Normansrule/twinkling-butterfly/docs/connections.md

# Pin-by-pin connections

Every pin of every active device, the net it sits on, and what else is on
that net. Generated by `hardware/make_connections.py` from the schematic
files, so it cannot drift from the design. Passive two-pin parts are listed
in the net summary at the bottom rather than getting a table each.

Net names follow the design's conventions exactly: `CHIP_ENABLE`, `BOOT`,
`LED_DATA`, `UART_RX`/`UART_TX` (named from the MCU's point of view),
`VBUS`, `VBAT`, `VBAT_SW`, `FT_3V3`, `+3.3V`, `GND`.

---

## ESP32-C3FH4 — Microcontroller

Bare QFN-32 MCU. 4 MB internal flash, so the six SPI flash pins are no-connects.

| Pin | Name | Net | Goes to |
|---|---|---|---|
| 1 | LNA_IN | — | **no connect** |
| 2 | VDD3P3 | `+3.3V` | C12.2, C19.1, C5.2, C6.2, C7.2, C8.2, C9.1, R1.1, R2.1, R3.1, R4.1,… |
| 3 | VDD3P3__1 | `+3.3V` | C12.2, C19.1, C5.2, C6.2, C7.2, C8.2, C9.1, R1.1, R2.1, R3.1, R4.1,… |
| 4 | GPIO0/XTAL_32K_P | — | **no connect** |
| 5 | GPIO1/XTAL_32K_N | — | **no connect** |
| 6 | GPIO2 | *(local)* | R2.2 |
| 7 | CHIP_EN | `CHIP_ENABLE` | C10.2, Q1.3, R1.2 |
| 8 | GPIO3 | — | **no connect** |
| 9 | GPIO4/MTMS | `LED_DATA` | R15.1 |
| 10 | GPIO5/MTDI | — | **no connect** |
| 11 | VDD3P3_RTC | `+3.3V` | C12.2, C19.1, C5.2, C6.2, C7.2, C8.2, C9.1, R1.1, R2.1, R3.1, R4.1,… |
| 12 | GPIO6/MTCK | — | **no connect** |
| 13 | GPIO7/MTDO | — | **no connect** |
| 14 | GPIO8 | *(local)* | R3.2 |
| 15 | GPIO9 | `BOOT` | Q2.3, R4.2 |
| 16 | GPIO10 | — | **no connect** |
| 17 | VDD3P3_CPU | `+3.3V` | C12.2, C19.1, C5.2, C6.2, C7.2, C8.2, C9.1, R1.1, R2.1, R3.1, R4.1,… |
| 18 | VDD_SPI | *(local)* | C11.2 |
| 19 | GPIO12/SPIHD | — | **no connect** |
| 20 | GPIO13/SPIWP | — | **no connect** |
| 21 | GPIO14/SPICS0 | — | **no connect** |
| 22 | GPIO15/SPICLK | — | **no connect** |
| 23 | GPIO16/SPID | — | **no connect** |
| 24 | GPIO17/SPIQ | — | **no connect** |
| 25 | GPIO18/USB_D- | `USB_DATA-` | TP2.1 |
| 26 | GPIO19/USB_D+ | `USB_DATA+` | TP1.1 |
| 27 | GPIO20/U0RXD | `UART_RX` | R9.2 |
| 28 | GPIO21/U0TXD | `UART_TX` | R10.2 |
| 29 | XTAL_N | `Crystal-` | 40.0MHz-Crystral.3, C4.2 |
| 30 | XTAL_P | `Crystal+` | 40.0MHz-Crystral.1, C3.2 |
| 31 | VDDA | `+3.3V` | C12.2, C19.1, C5.2, C6.2, C7.2, C8.2, C9.1, R1.1, R2.1, R3.1, R4.1,… |
| 32 | VDDA__1 | `+3.3V` | C12.2, C19.1, C5.2, C6.2, C7.2, C8.2, C9.1, R1.1, R2.1, R3.1, R4.1,… |
| 33 | GND | `GND` | 40.0MHz-Crystral.2, 40.0MHz-Crystral.4, BT1a.2, BT1b.2, C10.1, C11.… |

## U5 — USB / UART

USB to UART bridge. Runs from 5 V VBUS and regulates its own 3.3 V I/O.

| Pin | Name | Net | Goes to |
|---|---|---|---|
| 1 | ~{DTR} | `DTR` | Q2.2, R7.1 |
| 2 | ~{RTS} | `RTS` | Q1.2, R8.1 |
| 3 | VCCIO | `FT_3V3` | C15.1 |
| 4 | RXD | `FT_RXD` | R10.1 |
| 5 | ~{RI} | — | **no connect** |
| 6 | GND | `GND` | 40.0MHz-Crystral.2, 40.0MHz-Crystral.4, BT1a.2, BT1b.2, C10.1, C11.… |
| 7 | ~{DSR} | — | **no connect** |
| 8 | ~{DCD} | — | **no connect** |
| 9 | ~{CTS} | `GND` | 40.0MHz-Crystral.2, 40.0MHz-Crystral.4, BT1a.2, BT1b.2, C10.1, C11.… |
| 10 | CBUS2 | — | **no connect** |
| 11 | USBDP | `USB_DP` | R11.2 |
| 12 | USBDM | `USB_DM` | R12.2 |
| 13 | 3V3OUT | `FT_3V3` | C15.1 |
| 14 | ~{RESET} | `FT_3V3` | C15.1 |
| 15 | VCC | `VBUS` | C13.1, C14.1, C16.1, J1.A4/B9, J1.B4/A9, R13.1, U2.4, U4.5 |
| 16 | GND__1 | `GND` | 40.0MHz-Crystral.2, 40.0MHz-Crystral.4, BT1a.2, BT1b.2, C10.1, C11.… |
| 17 | CBUS1 | — | **no connect** |
| 18 | CBUS0 | — | **no connect** |
| 19 | CBUS3 | — | **no connect** |
| 20 | TXD | `FT_TXD` | R9.1 |

## U4 — USB / UART

USB ESD protection. Pins 1/6 are one node, 3/4 are the other.

| Pin | Name | Net | Goes to |
|---|---|---|---|
| 1 | ~ | `USB_DP_CONN` | J1.A6, J1.B6 |
| 2 | ~ | `GND` | 40.0MHz-Crystral.2, 40.0MHz-Crystral.4, BT1a.2, BT1b.2, C10.1, C11.… |
| 3 | ~ | `USB_DM_CONN` | J1.A7, J1.B7 |
| 4 | ~ | `USB_DM_P` | R12.1 |
| 5 | ~ | `VBUS` | C13.1, C14.1, C16.1, J1.A4/B9, J1.B4/A9, R13.1, U2.4, U5.15 |
| 6 | ~ | `USB_DP_P` | R11.1 |

## J1 — USB / UART

USB-C receptacle. Both halves of the data pair are tied so the cable can go in either way up.

| Pin | Name | Net | Goes to |
|---|---|---|---|
| A1/B12 | GND | `GND` | 40.0MHz-Crystral.2, 40.0MHz-Crystral.4, BT1a.2, BT1b.2, C10.1, C11.… |
| A4/B9 | VBUS | `VBUS` | C13.1, C14.1, C16.1, R13.1, U2.4, U4.5, U5.15 |
| A5 | CC1 | `CC1` | R5.1 |
| A6 | DP1 | `USB_DP_CONN` | U4.1 |
| A7 | DN1 | `USB_DM_CONN` | U4.3 |
| A8 | SBU1 | — | **no connect** |
| B1/A12 | GND__1 | `GND` | 40.0MHz-Crystral.2, 40.0MHz-Crystral.4, BT1a.2, BT1b.2, C10.1, C11.… |
| B4/A9 | VBUS__1 | `VBUS` | C13.1, C14.1, C16.1, R13.1, U2.4, U4.5, U5.15 |
| B5 | CC2 | `CC2` | R6.1 |
| B6 | DP2 | `USB_DP_CONN` | U4.1 |
| B7 | DN2 | `USB_DM_CONN` | U4.3 |
| B8 | SBU2 | — | **no connect** |
| S1 | GND__2 | `GND` | 40.0MHz-Crystral.2, 40.0MHz-Crystral.4, BT1a.2, BT1b.2, C10.1, C11.… |
| S2 | GND__3 | `GND` | 40.0MHz-Crystral.2, 40.0MHz-Crystral.4, BT1a.2, BT1b.2, C10.1, C11.… |
| S3 | GND__4 | `GND` | 40.0MHz-Crystral.2, 40.0MHz-Crystral.4, BT1a.2, BT1b.2, C10.1, C11.… |
| S4 | GND__5 | `GND` | 40.0MHz-Crystral.2, 40.0MHz-Crystral.4, BT1a.2, BT1b.2, C10.1, C11.… |

## Q1 — USB / UART

Pulls CHIP_ENABLE for esptool's auto-reset.

| Pin | Name | Net | Goes to |
|---|---|---|---|
| 1 | ~ | `Q1_BASE` | R7.2 |
| 2 | ~ | `RTS` | R8.1, U5.2 |
| 3 | ~ | `CHIP_ENABLE` | C10.2, ESP32-C3FH4.7, R1.2 |

## Q2 — USB / UART

Pulls BOOT for esptool's auto-reset.

| Pin | Name | Net | Goes to |
|---|---|---|---|
| 1 | ~ | `Q2_BASE` | R8.2 |
| 2 | ~ | `DTR` | R7.1, U5.1 |
| 3 | ~ | `BOOT` | ESP32-C3FH4.15, R4.2 |

## U2 — Power

Li-ion charge controller. I_REG(mA) = 1000 / R_PROG(kOhm); 24 kOhm gives ~42 mA.

| Pin | Name | Net | Goes to |
|---|---|---|---|
| 1 | STAT | `STAT` | D7.2 |
| 2 | VSS | `GND` | 40.0MHz-Crystral.2, 40.0MHz-Crystral.4, BT1a.2, BT1b.2, C10.1, C11.… |
| 3 | VBAT | `VBAT` | BT1a.1, BT1b.1, C17.1, SW1.1 |
| 4 | VDD | `VBUS` | C13.1, C14.1, C16.1, J1.A4/B9, J1.B4/A9, R13.1, U4.5, U5.15 |
| 5 | PROG | `PROG` | R14.1 |

## U3 — Power

3.3 V LDO for the MCU only. EN tied to VIN so SW1 kills it.

| Pin | Name | Net | Goes to |
|---|---|---|---|
| 1 | VIN | `VBAT_SW` | C18.1, C20.1, C21.1, C22.1, C23.1, C24.1, C25.1, C26.1, D1.1, D2.1,… |
| 2 | GND | `GND` | 40.0MHz-Crystral.2, 40.0MHz-Crystral.4, BT1a.2, BT1b.2, C10.1, C11.… |
| 3 | EN | `VBAT_SW` | C18.1, C20.1, C21.1, C22.1, C23.1, C24.1, C25.1, C26.1, D1.1, D2.1,… |
| 4 | NC | — | **no connect** |
| 5 | VOUT | `+3.3V` | C12.2, C19.1, C5.2, C6.2, C7.2, C8.2, C9.1, ESP32-C3FH4.11, ESP32-C… |

## SW1 — Power

SPDT slide switch, surface mount. Pin 2 is the common terminal.

| Pin | Name | Net | Goes to |
|---|---|---|---|
| 1 | A | `VBAT` | BT1a.1, BT1b.1, C17.1, U2.3 |
| 2 | COM | `VBAT_SW` | C18.1, C20.1, C21.1, C22.1, C23.1, C24.1, C25.1, C26.1, D1.1, D2.1,… |
| 3 | B | — | **no connect** |

## D1 — LED chain

| Pin | Name | Net | Goes to |
|---|---|---|---|
| 1 | VDD | `VBAT_SW` | C18.1, C20.1, C21.1, C22.1, C23.1, C24.1, C25.1, C26.1, D2.1, D3.1,… |
| 2 | DOUT | `PIX_D1` | D2.4 |
| 3 | VSS | `GND` | 40.0MHz-Crystral.2, 40.0MHz-Crystral.4, BT1a.2, BT1b.2, C10.1, C11.… |
| 4 | DIN | `PIX_D0` | R15.2 |

## D2 — LED chain

| Pin | Name | Net | Goes to |
|---|---|---|---|
| 1 | VDD | `VBAT_SW` | C18.1, C20.1, C21.1, C22.1, C23.1, C24.1, C25.1, C26.1, D1.1, D3.1,… |
| 2 | DOUT | `PIX_D2` | D3.4 |
| 3 | VSS | `GND` | 40.0MHz-Crystral.2, 40.0MHz-Crystral.4, BT1a.2, BT1b.2, C10.1, C11.… |
| 4 | DIN | `PIX_D1` | D1.2 |

## D3 — LED chain

| Pin | Name | Net | Goes to |
|---|---|---|---|
| 1 | VDD | `VBAT_SW` | C18.1, C20.1, C21.1, C22.1, C23.1, C24.1, C25.1, C26.1, D1.1, D2.1,… |
| 2 | DOUT | `PIX_D3` | D4.4 |
| 3 | VSS | `GND` | 40.0MHz-Crystral.2, 40.0MHz-Crystral.4, BT1a.2, BT1b.2, C10.1, C11.… |
| 4 | DIN | `PIX_D2` | D2.2 |

## D4 — LED chain

| Pin | Name | Net | Goes to |
|---|---|---|---|
| 1 | VDD | `VBAT_SW` | C18.1, C20.1, C21.1, C22.1, C23.1, C24.1, C25.1, C26.1, D1.1, D2.1,… |
| 2 | DOUT | `PIX_D4` | D5.4 |
| 3 | VSS | `GND` | 40.0MHz-Crystral.2, 40.0MHz-Crystral.4, BT1a.2, BT1b.2, C10.1, C11.… |
| 4 | DIN | `PIX_D3` | D3.2 |

## D5 — LED chain

| Pin | Name | Net | Goes to |
|---|---|---|---|
| 1 | VDD | `VBAT_SW` | C18.1, C20.1, C21.1, C22.1, C23.1, C24.1, C25.1, C26.1, D1.1, D2.1,… |
| 2 | DOUT | `PIX_D5` | D6.4 |
| 3 | VSS | `GND` | 40.0MHz-Crystral.2, 40.0MHz-Crystral.4, BT1a.2, BT1b.2, C10.1, C11.… |
| 4 | DIN | `PIX_D4` | D4.2 |

## D6 — LED chain

| Pin | Name | Net | Goes to |
|---|---|---|---|
| 1 | VDD | `VBAT_SW` | C18.1, C20.1, C21.1, C22.1, C23.1, C24.1, C25.1, C26.1, D1.1, D2.1,… |
| 2 | DOUT | — | **no connect** |
| 3 | VSS | `GND` | 40.0MHz-Crystral.2, 40.0MHz-Crystral.4, BT1a.2, BT1b.2, C10.1, C11.… |
| 4 | DIN | `PIX_D5` | D5.2 |

## D7 — Power

| Pin | Name | Net | Goes to |
|---|---|---|---|
| 1 | A | `CHG_A` | R13.2 |
| 2 | K | `STAT` | U2.1 |

## 40.0MHz-Crystral — Microcontroller

| Pin | Name | Net | Goes to |
|---|---|---|---|
| 1 | ~ | `Crystal+` | C3.2, ESP32-C3FH4.30 |
| 2 | GND | `GND` | BT1a.2, BT1b.2, C10.1, C11.1, C12.1, C13.2, C14.2, C15.2, C16.2, C1… |
| 3 | ~ | `Crystal-` | C4.2, ESP32-C3FH4.29 |
| 4 | GND__1 | `GND` | BT1a.2, BT1b.2, C10.1, C11.1, C12.1, C13.2, C14.2, C15.2, C16.2, C1… |

---

## Every net

| Net | Pins on it |
|---|---|
| `+3.3V` | C12.2, C19.1, C5.2, C6.2, C7.2, C8.2, C9.1, ESP32-C3FH4.11, ESP32-C3FH4.17, ESP32-C3FH4.2, ESP32-C3FH4.3, ESP32-C3FH4.31, ESP32-C3FH4.32, R1.1, R2.1, R3.1, R4.1, U3.5 |
| `BOOT` | ESP32-C3FH4.15, Q2.3, R4.2 |
| `CC1` | J1.A5, R5.1 |
| `CC2` | J1.B5, R6.1 |
| `CHG_A` | D7.1, R13.2 |
| `CHIP_ENABLE` | C10.2, ESP32-C3FH4.7, Q1.3, R1.2 |
| `Crystal+` | 40.0MHz-Crystral.1, C3.2, ESP32-C3FH4.30 |
| `Crystal-` | 40.0MHz-Crystral.3, C4.2, ESP32-C3FH4.29 |
| `DTR` | Q2.2, R7.1, U5.1 |
| `FT_3V3` | C15.1, U5.13, U5.14, U5.3 |
| `FT_RXD` | R10.1, U5.4 |
| `FT_TXD` | R9.1, U5.20 |
| `GND` | 40.0MHz-Crystral.2, 40.0MHz-Crystral.4, BT1a.2, BT1b.2, C10.1, C11.1, C12.1, C13.2, C14.2, C15.2, C16.2, C17.2, C18.2, C19.2, C20.2, C21.2, C22.2, C23.2, C24.2, C25.2, C26.2, C3.1, C4.1, C5.1, C6.1, C7.1, C8.1, C9.2, D1.3, D2.3, D3.3, D4.3, D5.3, D6.3, ESP32-C3FH4.33, J1.A1/B12, J1.B1/A12, J1.S1, J1.S2, J1.S3, J1.S4, R14.2, R5.2, R6.2, U2.2, U3.2, U4.2, U5.16, U5.6, U5.9 |
| `LED_DATA` | ESP32-C3FH4.9, R15.1 |
| `PIX_D0` | D1.4, R15.2 |
| `PIX_D1` | D1.2, D2.4 |
| `PIX_D2` | D2.2, D3.4 |
| `PIX_D3` | D3.2, D4.4 |
| `PIX_D4` | D4.2, D5.4 |
| `PIX_D5` | D5.2, D6.4 |
| `PROG` | R14.1, U2.5 |
| `Q1_BASE` | Q1.1, R7.2 |
| `Q2_BASE` | Q2.1, R8.2 |
| `RTS` | Q1.2, R8.1, U5.2 |
| `STAT` | D7.2, U2.1 |
| `UART_RX` | ESP32-C3FH4.27, R9.2 |
| `UART_TX` | ESP32-C3FH4.28, R10.2 |
| `USB_DATA+` | ESP32-C3FH4.26, TP1.1 |
| `USB_DATA-` | ESP32-C3FH4.25, TP2.1 |
| `USB_DM` | R12.2, U5.12 |
| `USB_DM_CONN` | J1.A7, J1.B7, U4.3 |
| `USB_DM_P` | R12.1, U4.4 |
| `USB_DP` | R11.2, U5.11 |
| `USB_DP_CONN` | J1.A6, J1.B6, U4.1 |
| `USB_DP_P` | R11.1, U4.6 |
| `VBAT` | BT1a.1, BT1b.1, C17.1, SW1.1, U2.3 |
| `VBAT_SW` | C18.1, C20.1, C21.1, C22.1, C23.1, C24.1, C25.1, C26.1, D1.1, D2.1, D3.1, D4.1, D5.1, D6.1, SW1.2, U3.1, U3.3 |
| `VBUS` | C13.1, C14.1, C16.1, J1.A4/B9, J1.B4/A9, R13.1, U2.4, U4.5, U5.15 |
| `__NC__` |  |
