Normansrule/twinkling-butterfly/docs/handoff-2026-08-31.md

# Twinkling Butterfly — Project Handoff
### Custom PCB, KiCad 10.0.5, hierarchical schematic | Handoff date: August 31, 2026

## What this project is

A butterfly-shaped ornament with 6 addressable RGB LEDs (WS2812B) that twinkle at night. Powered by two LIR2032 rechargeable coin cells in parallel (~80 mAh), charged over USB-C, reprogrammable over the same USB-C port via an onboard USB-to-UART bridge with auto-program transistors (no BOOT/RESET buttons — the only physical control is a power slide switch). Everything hand-soldered: all passives 1206 or larger, leaded or large-pad packages everywhere except the QFN-32 MCU, SSOP-20 bridge, SOT-23 parts, and the USB-C connector.

## Architecture in one paragraph

USB-C VBUS feeds an MCP73831 charger (≈42 mA via 24 kΩ PROG) into the battery pair, and feeds the FT231XS bridge's VCC directly. The battery runs through slide switch SW1 into an AP2112K-3.3 LDO for the ESP32-C3FH4 (bare chip, 4 MB internal flash, 40 MHz crystal). The FT231XS converts USB to UART on GPIO20/21 and its DTR#/RTS# drive two cross-coupled MMBT2222A transistors that pull CHIP_EN and GPIO9 for esptool's one-click flashing. GPIO4 drives the WS2812B chain (powered from the switched battery rail, not the LDO). Native USB (GPIO18/19) goes to test pads as a backup flashing path. The charger stays wired to the battery so charging works with SW1 off; the ESP32 must be ON to flash.

## Design decisions already settled (do not relitigate without cause)

1. Bare ESP32-C3FH4 over modules — user explicitly banned modules and is comfortable with QFN and complex routing.
2. FT231XS replaced CH340C because DigiKey no longer stocks CH340C as a bare chip. Bonus: FT231XS runs from 5 V VBUS with internal 3.3 V I/O regulation, which eliminated the second LDO entirely.
3. USB4110-GF-A (all-SMD) replaced USB4105 (hybrid THT) at user request for surface-mount.
4. Two LIR2032 in parallel (NOT series) — keeps single-cell charging, 3.0–4.2 V rail, ~80 mAh, ~40–60 mA continuous capability. Same brand/batch, replaced as a pair, holders labeled LIR ONLY (CR2032 here = fire risk).
5. WS2812B ×6 (trimmed from 8: idle draw ~0.8 mA each matters on coin cells). Firmware caps brightness ~10%, max 3 pixels lit at once, light sleep between frames. Runtime ≈ 3–4 h/charge.
6. All passives 1206; crystal in 5032 4-pad package for hand-solderability.
7. Amber-only single-color LEDs and the pouch-cell/XIAO variants were earlier iterations (v1/v2) and are superseded.

## Net naming conventions (exact spellings matter)

- `CHIP_ENABLE` — ESP pin 7 node (pin + R1 10k-to-3V3 + C10 1 µF + label). Q1 collector pulls it.
- `BOOT` — GPIO9 (pin 15) node (pin + R4 10k-to-3V3 + label, deliberately NO cap). Q2 collector pulls it.
- `LED_DATA` — GPIO4 (pin 9) → 470 Ω → first WS2812B DIN.
- `UART_RX` / `UART_TX` — named from the MCU's point of view. UART_TX (ESP pin 28) → FT231XS RXD; UART_RX (ESP pin 27) ← FT231XS TXD. Each has a 470 Ω series resistor on the bridge side.
- `USB_DATA+` / `USB_DATA−` — GPIO19/18 to test pads on the MCU sheet (backup native-USB flashing).
- `VBUS` (5 V from USB), `+3.3V` (battery-fed LDO output), `VBAT_SW` (switched battery rail feeding LDO and LED chain), GND. Power symbols are global; only signals use hierarchical labels/sheet pins.

## Current KiCad state

- Root: Main.kicad_sch. Child sheet "Microcontroller" exists; its 7 sheet pins are imported into the root.
- **Microcontroller sheet: COMPLETE and reviewed.** All 33 pins dispositioned: power pins with caps (10 µF + 0.1 µF at VDD3P3 pins 2/3; 0.1 µF each at VDD3P3_RTC 11, VDD3P3_CPU 17, VDDA 31/32; 1 µF alone on VDD_SPI 18 with no rail connection), EPAD 33 to GND, crystal on pins 29/30 with two 12 pF caps and grounded case pads, GPIO2/GPIO8 pull-ups (no labels), CHIP_ENABLE RC + label (cap confirmed on the pin side of R1, not the 3.3 V side), BOOT pull-up + label, 14 NC flags including all six in-package-flash SPI pins (19–24) and GPIO10.
- **USB/UART sheet: fully specified, not yet drawn.** Complete pin-by-pin spec for USB4110 + USBLC6-2SC6 + FT231XS + Q1/Q2 was delivered in the prior conversation; key FT231XS facts: VCC (15) from VBUS with 4.7 µF + 0.1 µF; 3V3OUT (13) + VCCIO (3) + RESET# (14) tied as one node with 0.1 µF; CTS# (9) to GND; 27 Ω series on USBDP (11)/USBDM (12); TXD (20)→470 Ω→UART_RX; RXD (4)←470 Ω←UART_TX; DTR# (1)/RTS# (2) to the transistor cross: Q1 base←10k←DTR, emitter←RTS, collector→CHIP_ENABLE; Q2 base←10k←RTS, emitter←DTR, collector→BOOT.
- **Power sheet: not started.** MCP73831 (STAT→LED+1k→VBUS; VSS→GND; VBAT→BAT+ with 4.7 µF; VDD→VBUS with 4.7 µF; PROG→24 kΩ), SW1 common→VBAT_SW, AP2112K (VIN=VBAT_SW, EN tied to VIN, VOUT→+3.3V, 1 µF each side), two Keystone 3034 holders in parallel.
- **LED sheet: not started.** 6× WS2812B chained (VDD→VBAT_SW, VSS→GND, DOUT→next DIN), 0.1 µF per pixel, 470 µF electrolytic across VBAT_SW at the first pixel, DIN of first ←470 Ω←LED_DATA.
- KiCad libraries in use: Device:Crystal_GND24 + Crystal:Crystal_SMD_Abracon_ABM3B-4Pin_5.0x3.2mm; Battery_Management:MCP73831-2-OT; Regulator_Linear:AP2112K-3.3; Power_Protection:USBLC6-2SC6; LED:WS2812B + LED_SMD:LED_WS2812B_PLCC4_5.0x5.0mm_P3.2mm; Transistor_BJT:MMBT2222A; Interface_USB:FT231XS + Package_SO:SSOP-20_4.4x6.5mm_P0.65mm; Connector:USB_C_Receptacle_USB2.0_16P + Connector_USB:USB_C_Receptacle_GCT_USB4110-xx-A; TestPoint:TestPoint_Pad_1.5x1.5mm. Missing items → DigiKey product page "EDA & CAD Models" or SnapEDA.

## Consolidated BOM (all DigiKey search links)

| Ref | Part | Link |
|---|---|---|
| U1 | ESP32-C3FH4 (QFN-32) | https://www.digikey.com/en/products/result?keywords=ESP32-C3FH4 |
| U2 | MCP73831T-2ACI/OT | https://www.digikey.com/en/products/result?keywords=MCP73831T-2ACI%2FOT |
| U3 | AP2112K-3.3TRG1 | https://www.digikey.com/en/products/result?keywords=AP2112K-3.3TRG1 |
| U4 | USBLC6-2SC6 | https://www.digikey.com/en/products/result?keywords=USBLC6-2SC6 |
| U5 | FT231XS-R | https://www.digikey.com/en/products/result?keywords=FT231XS-R |
| Q1, Q2 | MMBT2222A ×2 | https://www.digikey.com/en/products/result?keywords=MMBT2222A |
| J1 | USB4110-GF-A | https://www.digikey.com/en/products/result?keywords=USB4110-GF-A |
| Y1 | ABM3B-40.000MHZ-10-1-U-T | https://www.digikey.com/en/products/result?keywords=ABM3B-40.000MHZ-10-1-U-T |
| BT1a/b | LIR2032 ×2 | https://www.digikey.com/en/products/result?keywords=LIR2032 |
| — | Keystone 3034 holders ×2 | https://www.digikey.com/en/products/result?keywords=Keystone%203034 |
| SW1 | OS102011MA1QN1 | https://www.digikey.com/en/products/result?keywords=OS102011MA1QN1 |
| D1–D6 | WS2812B ×6 | https://www.digikey.com/en/products/result?keywords=WS2812B |
| D_CHG | Any 1206 LED | (charge indicator) |
| 10 kΩ 1206 ×7 | R1–R4, R7, R8, +1 spare | https://www.digikey.com/en/products/result?keywords=RC1206FR-0710KL |
| 5.1 kΩ 1206 ×2 | R5, R6 (CC) | https://www.digikey.com/en/products/result?keywords=RC1206FR-075K1L |
| 470 Ω 1206 ×3 | R9, R10 (UART), R_DATA | https://www.digikey.com/en/products/result?keywords=RC1206FR-07470RL |
| 27 Ω 1206 ×2 | R11, R12 (USB) | https://www.digikey.com/en/products/result?keywords=RC1206FR-0727RL |
| 24 kΩ 1206 ×1 | R_PROG | https://www.digikey.com/en/products/result?keywords=24k%20ohm%201206%201%25 |
| 1 kΩ 1206 ×1 | charge LED | https://www.digikey.com/en/products/result?keywords=1k%20ohm%201206%201%25 |
| 12 pF C0G 1206 ×2 | C3, C4 (crystal) | https://www.digikey.com/en/products/result?keywords=C1206C120J5GACTU |
| 0.1 µF 1206 ×~12 | MCU ×5, FT231XS ×2, WS2812 ×6 | https://www.digikey.com/en/products/result?keywords=C1206C104K5RACTU |
| 1 µF 1206 ×4 | C_EN, VDD_SPI, LDO in/out | https://www.digikey.com/en/products/result?keywords=C1206C105K3RACTU |
| 4.7 µF 1206 ×3 | charger ×2, FT231XS VCC | https://www.digikey.com/en/products/result?keywords=4.7uF%201206%20X5R%2025V |
| 10 µF 1206 ×1 | MCU rail | https://www.digikey.com/en/products/result?keywords=CL31A106KAHNNNE |
| 470 µF 10 V radial ×1 | LED rail bulk | https://www.digikey.com/en/products/result?keywords=470uF%2010V%20radial |

## Firmware status

Working sketch exists (butterfly_v2_twinkle.ino from the earlier XIAO iteration): random-target twinkle logic with gamma correction, esp_random() seeding, auto-off deep sleep after 8 h. Port for this board: replace the 5-pin LEDC code with Adafruit_NeoPixel or FastLED on GPIO4, setBrightness(~25), limit to ≤3 simultaneous lit pixels, add light sleep between frames. Arduino IDE: esp32 core, board = "ESP32C3 Dev Module", flash via the FT231XS COM port (auto-reset works; no buttons).

## Remaining work, in order

1. Draw the USB/UART sheet from the spec above; import its 4 sheet pins (CHIP_ENABLE, BOOT, UART_RX, UART_TX); wire to the MCU box in root.
2. Add the two USB_DATA test pads on the MCU sheet.
3. Draw the Power sheet; draw the LED sheet.
4. Full ERC to zero (or explained) warnings.
5. Footprint assignment pass, then PCB layout. Layout notes already flagged: crystal within 5 mm of pins 29/30 with ground pour; QFN EPAD stitched with 4–9 vias (it is the chip's ONLY ground); USB pair short and matched, away from crystal; ground pour under USB-C shield pads (they're the only mechanical anchor); 470 µF at first pixel; MCP73831 thermal relief.
6. 3D check (Alt+3), DRC, fab (user 3D-prints, so the board outline should eventually be butterfly-shaped or fit a printed body).

---

# Upgrade path: proper 5 V NeoPixel drive for maximum brightness

WS2812Bs are noticeably brighter and truer-colored at 5 V — blue and green dim badly below ~3.5 V supply, which is why colors shift as a LiPo discharges. Running them at 5 V "properly" needs two additions, because two separate specs break:

**Problem 1 — supply.** The battery gives 3.0–4.2 V, so a boost converter must create the 5 V LED rail.
- **U7 — MCP1640T-I/OT** boost converter, SOT-23-6, hand-solderable — https://www.digikey.com/en/products/result?keywords=MCP1640T-I%2FOT
- **L1 — 4.7 µH power inductor**, ~1 A sat, two-pad shielded (e.g., Bourns SRN4018 series) — https://www.digikey.com/en/products/result?keywords=SRN4018-4R7M
- **C — 10 µF 1206 in, 2× 10 µF 1206 out** (same CL31A106KAHNNNE)
- **Feedback divider:** VOUT = 1.21 V × (1 + R_top/R_bot). Use **R_top = 470 kΩ, R_bot = 150 kΩ** → 5.00 V. 1206: https://www.digikey.com/en/products/result?keywords=470k%201206%201%25 and https://www.digikey.com/en/products/result?keywords=150k%201206%201%25
- Wiring: VIN + EN ← VBAT_SW (EN tied to VIN so SW1 still kills everything); SW pin → inductor → ... per the datasheet's standard boost topology (verify pin roles against the MCP1640 datasheet when drawing; SOT-23-6 is SW, GND, FB, EN, VIN, VOUT). The 5 V output becomes the new LED rail `+5V_LED`; move the 470 µF and the per-pixel 0.1 µFs onto it.

**Problem 2 — logic level.** A WS2812B at 5 V requires data-high ≥ 0.7 × VDD = 3.5 V, and the ESP32's 3.3 V no longer qualifies; pixels glitch or ignore data. The canonical fix:
- **U8 — SN74AHCT1G125DBVR**, single-gate buffer, SOT-23-5 — https://www.digikey.com/en/products/result?keywords=SN74AHCT1G125DBVR
- The AHCT family has TTL input thresholds (VIH = 2.0 V), so it reads 3.3 V cleanly while its output swings the full 5 V.
- Wiring: pin 5 VCC → `+5V_LED` with 0.1 µF; pin 3 GND; pin 2 A ← `LED_DATA` from GPIO4; pin 1 OE̅ → GND (always enabled); pin 4 Y → 470 Ω → first pixel DIN. The 470 Ω moves to the 5 V side of the buffer.

**The honest physics caveat:** boosting doubles the current story. Six pixels at even 40% brightness ≈ 290 mA at 5 V ≈ 450+ mA drawn from the battery through the boost. Two LIR2032s cannot do that — they'll sag and brown out the board. So this upgrade only makes sense paired with the 500 mAh pouch cell (swap R_PROG to 2 kΩ for ~500 mA charging, delete the coin holders, add JST S2B-PH-K-S — https://www.digikey.com/en/products/result?keywords=S2B-PH-K-S ). On the coin pair, skip the boost entirely and keep the 3.0–4.2 V direct-drive design; capped at 10% brightness the color shift is barely visible. A good compromise: lay out the boost + buffer + JST footprints on the PCB but leave them unpopulated (DNP) on coin-cell builds — one board, both personalities.

## Handoff prompt for the next chat

"I'm building a custom KiCad 10 PCB called Twinkling Butterfly — bare ESP32-C3FH4, FT231XS USB-C programming with auto-reset transistors, MCP73831 charging, 2× LIR2032 parallel, 6× WS2812B. The Microcontroller hierarchical sheet is complete and its pins are imported to root. I'm attaching the handoff doc; next task is drawing the USB/UART sheet per its spec. Walk me through it the same pin-by-pin way."
