Normansrule/twinkling-butterfly/docs/netlist.md

# Netlist

Generated by `hardware/validate_sheets.py` from the written schematic files.

| Net | Connections |
|---|---|
| `+3.3V` | C12.2, C19.1, C5.2, C6.2, C7.2, C8.2, C9.1, ESP32-C3FH4.11 (VDD3P3_RTC), ESP32-C3FH4.17 (VDD3P3_CPU), ESP32-C3FH4.2 (VDD3P3), ESP32-C3FH4.3 (VDD3P3__1), ESP32-C3FH4.31 (VDDA), ESP32-C3FH4.32 (VDDA__1), R1.1, R2.1, R3.1, R4.1, U3.5 (VOUT) |
| `BOOT` | ESP32-C3FH4.15 (GPIO9), Q2.3, R4.2 |
| `CC1` | J1.A5 (CC1), R5.1 |
| `CC2` | J1.B5 (CC2), R6.1 |
| `CHG_A` | D7.1 (A), R13.2 |
| `CHIP_ENABLE` | C10.2, ESP32-C3FH4.7 (CHIP_EN), Q1.3, R1.2 |
| `Crystal+` | 40.0MHz-Crystral.1, C3.2, ESP32-C3FH4.30 (XTAL_P) |
| `Crystal-` | 40.0MHz-Crystral.3, C4.2, ESP32-C3FH4.29 (XTAL_N) |
| `DTR` | Q2.2, R7.1, U5.1 (~{DTR}) |
| `FT_3V3` | C15.1, U5.13 (3V3OUT), U5.14 (~{RESET}), U5.3 (VCCIO) |
| `FT_RXD` | R10.1, U5.4 (RXD) |
| `FT_TXD` | R9.1, U5.20 (TXD) |
| `GND` | 40.0MHz-Crystral.2 (GND), 40.0MHz-Crystral.4 (GND__1), BT1a.2 (-), BT1b.2 (-), C10.1, C11.1, C12.1, C13.2, C14.2, C15.2, C16.2, C17.2, C18.2, C19.2, C20.2, C21.2, C22.2, C23.2, C24.2, C25.2, C26.2 (-), C3.1, C4.1, C5.1, C6.1, C7.1, C8.1, C9.2, D1.3 (VSS), D2.3 (VSS), D3.3 (VSS), D4.3 (VSS), D5.3 (VSS), D6.3 (VSS), ESP32-C3FH4.33 (GND), J1.A1/B12 (GND), J1.B1/A12 (GND__1), J1.S1 (GND__2), J1.S2 (GND__3), J1.S3 (GND__4), J1.S4 (GND__5), R14.2, R5.2, R6.2, U2.2 (VSS), U3.2 (GND), U4.2, U5.16 (GND__1), U5.6 (GND), U5.9 (~{CTS}) |
| `LED_DATA` | ESP32-C3FH4.9 (GPIO4/MTMS), R15.1 |
| `PIX_D0` | D1.4 (DIN), R15.2 |
| `PIX_D1` | D1.2 (DOUT), D2.4 (DIN) |
| `PIX_D2` | D2.2 (DOUT), D3.4 (DIN) |
| `PIX_D3` | D3.2 (DOUT), D4.4 (DIN) |
| `PIX_D4` | D4.2 (DOUT), D5.4 (DIN) |
| `PIX_D5` | D5.2 (DOUT), D6.4 (DIN) |
| `PROG` | R14.1, U2.5 (PROG) |
| `Q1_BASE` | Q1.1, R7.2 |
| `Q2_BASE` | Q2.1, R8.2 |
| `RTS` | Q1.2, R8.1, U5.2 (~{RTS}) |
| `STAT` | D7.2 (K), U2.1 (STAT) |
| `UART_RX` | ESP32-C3FH4.27 (GPIO20/U0RXD), R9.2 |
| `UART_TX` | ESP32-C3FH4.28 (GPIO21/U0TXD), R10.2 |
| `USB_DATA+` | ESP32-C3FH4.26 (GPIO19/USB_D+), TP1.1 |
| `USB_DATA-` | ESP32-C3FH4.25 (GPIO18/USB_D-), TP2.1 |
| `USB_DM` | R12.2, U5.12 (USBDM) |
| `USB_DM_CONN` | J1.A7 (DN1), J1.B7 (DN2), U4.3 |
| `USB_DM_P` | R12.1, U4.4 |
| `USB_DP` | R11.2, U5.11 (USBDP) |
| `USB_DP_CONN` | J1.A6 (DP1), J1.B6 (DP2), U4.1 |
| `USB_DP_P` | R11.1, U4.6 |
| `VBAT` | BT1a.1 (+), BT1b.1 (+), C17.1, SW1.1 (A), U2.3 (VBAT) |
| `VBAT_SW` | C18.1, C20.1, C21.1, C22.1, C23.1, C24.1, C25.1, C26.1 (+), D1.1 (VDD), D2.1 (VDD), D3.1 (VDD), D4.1 (VDD), D5.1 (VDD), D6.1 (VDD), SW1.2 (COM), U3.1 (VIN), U3.3 (EN) |
| `VBUS` | C13.1, C14.1, C16.1, J1.A4/B9 (VBUS), J1.B4/A9 (VBUS__1), R13.1, U2.4 (VDD), U4.5, U5.15 (VCC) |
| `<unnamed@(134.62, 60.96)>` | C11.2, ESP32-C3FH4.18 (VDD_SPI) |
| `<unnamed@(144.78, 71.12)>` | ESP32-C3FH4.14 (GPIO8), R3.2 |
| `<unnamed@(72.39, 83.82)>` | ESP32-C3FH4.6 (GPIO2), R2.2 |
