Normansrule/twinkling-butterfly/mechanical/butterfly_board.stl

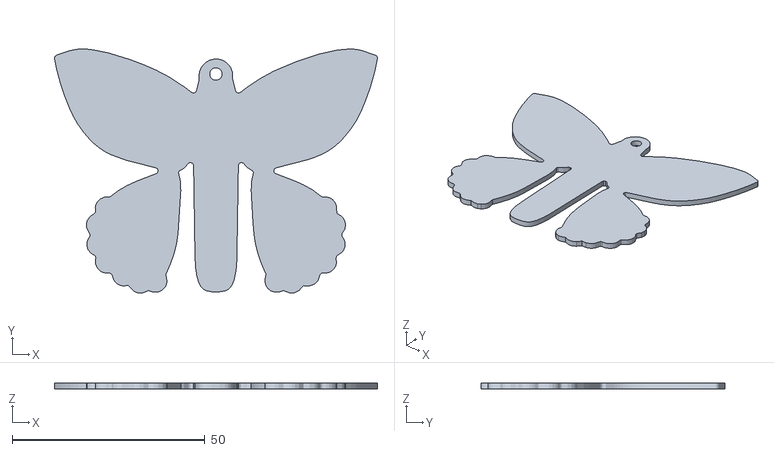
[picture p2: CAD file, 2026-10-02]
mechanical/butterfly_board.stl
83.7 x 63.3 x 1.60
