Normansrule/twinkling-butterfly/mechanical/butterfly_stand.stl

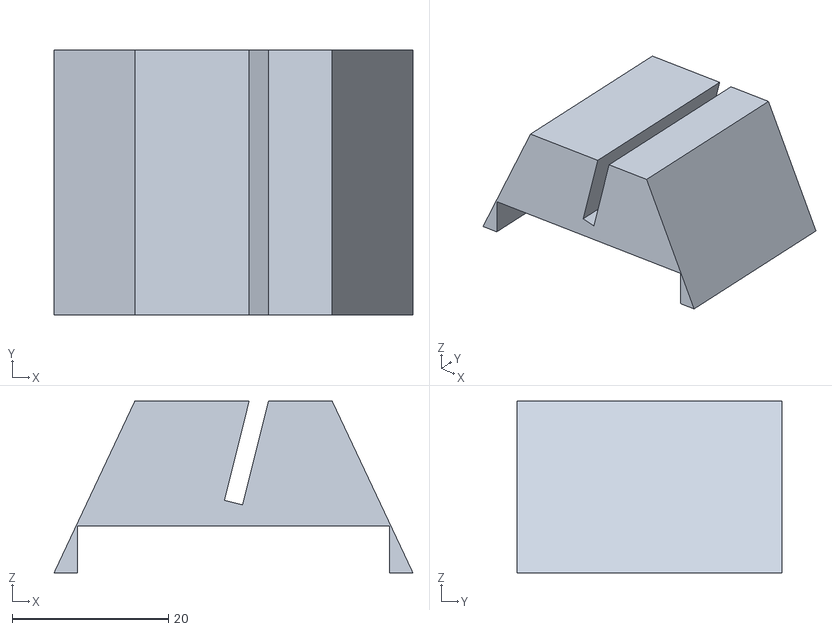
[picture p3: CAD file, 2026-10-02]
mechanical/butterfly_stand.stl
46.0 x 34.0 x 22.0
