Normansrule/twinkling-butterfly/mechanical/butterfly_outline.dxf

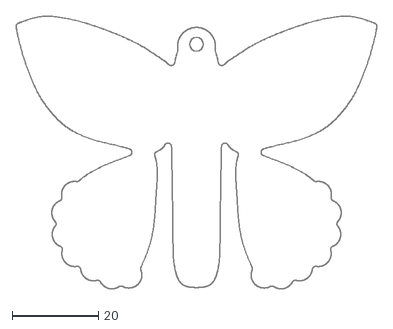
[picture p4: CAD file, 2026-10-02]
mechanical/butterfly_outline.dxf
83.8 x 63.3
