Normansrule/twinkling-butterfly/hardware/LED Butterfly/LED.kicad_sch

## KiCad design hardware/LED Butterfly/LED.kicad_sch (2026-10-02)

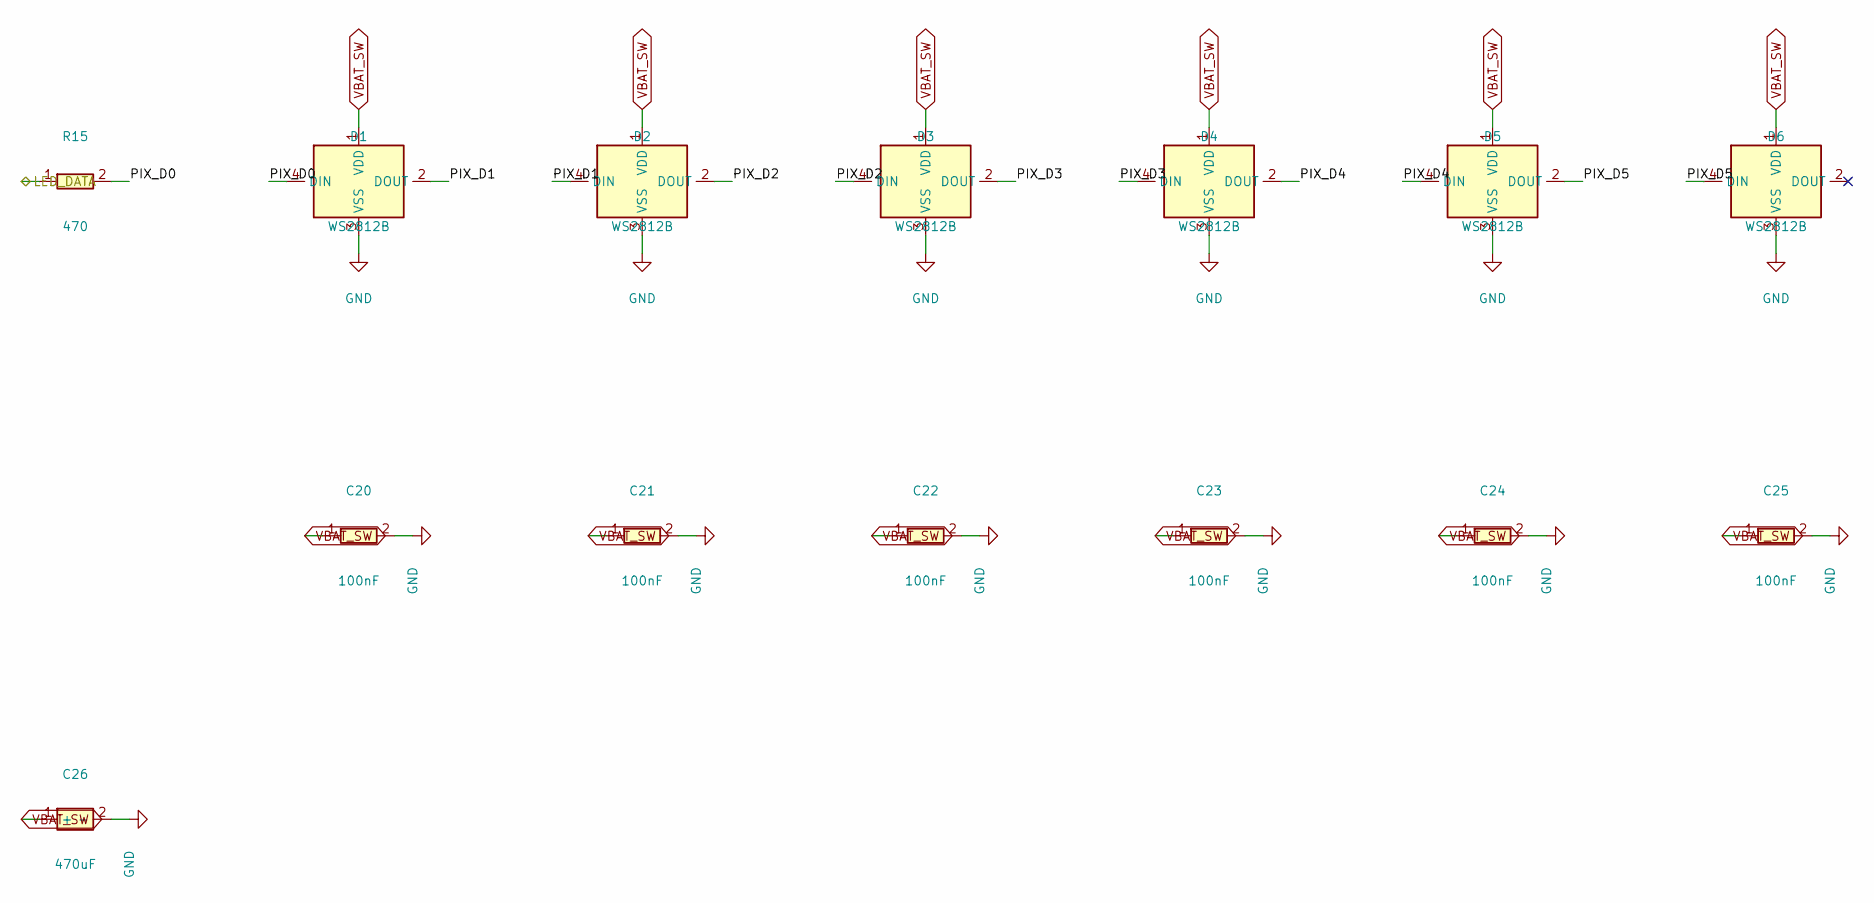
[picture p5: schematic LED.kicad_sch]

Parts:
C20, C21, C22, C23, C24, C25: 100nF; C_1206_3216Metric
C26: 470uF; CP_Elec_8x10.5
D1, D2, D3, D4, D5, D6: WS2812B; LED_WS2812B_PLCC4_5.0x5.0mm_P3.2mm
R15: 470; R_1206_3216Metric

Connections:
GND: C20.2, C21.2, C22.2, C23.2, C24.2, C25.2, C26.2 (-), D1.3 (VSS), D2.3 (VSS), D3.3 (VSS), D4.3 (VSS), D5.3 (VSS), D6.3 (VSS)
LED_DATA: R15.1
PIX_D0: D1.4 (DIN), R15.2
PIX_D1: D1.2 (DOUT), D2.4 (DIN)
PIX_D2: D2.2 (DOUT), D3.4 (DIN)
PIX_D3: D3.2 (DOUT), D4.4 (DIN)
PIX_D4: D4.2 (DOUT), D5.4 (DIN)
PIX_D5: D5.2 (DOUT), D6.4 (DIN)
VBAT_SW: C20.1, C21.1, C22.1, C23.1, C24.1, C25.1, C26.1 (+), D1.1 (VDD), D2.1 (VDD), D3.1 (VDD), D4.1 (VDD), D5.1 (VDD), D6.1 (VDD)
