Normansrule/twinkling-butterfly/hardware/LED Butterfly/Main.kicad_sch

## KiCad design hardware/LED Butterfly/Main.kicad_sch (2026-10-02)

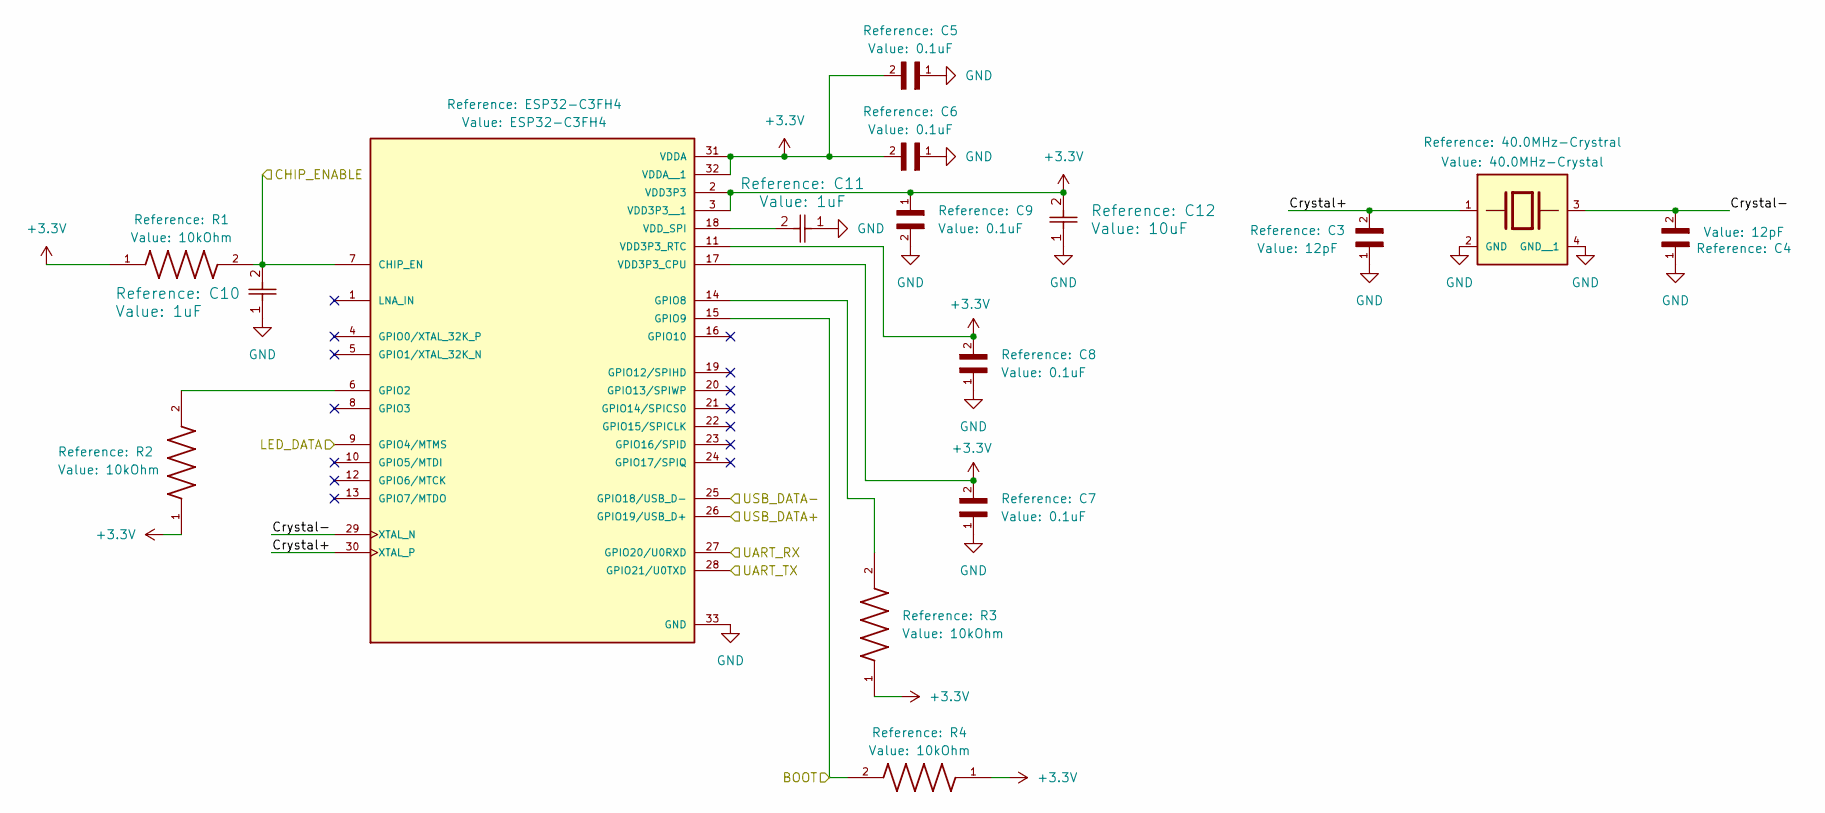
[picture p6: schematic Main.kicad_sch]

Parts:
40.0MHz-Crystral: 40.0MHz-Crystal; XTAL_ABM3B-40.000MHZ-10-1-U-T; PARTREV 08.25.15
C3, C4: 12pF; CAPC3216X94N
C5, C6, C7, C8, C9: 0.1uF; VARC3216X85N
C10, C11: 1uF; CAPC340180_140N_KEM-L
C12: 10uF; CAP_CL31_SAM-L
ESP32-C3FH4: ESP32-C3FH4; QFN50P500X500X90-33N; PARTREV 2.0
R1, R2, R3, R4: 10kOhm; RESC3116X65N

Connections:
+3.3V: C5.2, C6.2, C7.2, C8.2, C9.1, C12.2, ESP32-C3FH4.2 (VDD3P3), ESP32-C3FH4.3 (VDD3P3__1), ESP32-C3FH4.11 (VDD3P3_RTC), ESP32-C3FH4.17 (VDD3P3_CPU), ESP32-C3FH4.31 (VDDA), ESP32-C3FH4.32 (VDDA__1), R1.1, R2.1, R3.1, R4.1
BOOT: ESP32-C3FH4.15 (GPIO9), R4.2
CHIP_ENABLE: C10.2, ESP32-C3FH4.7 (CHIP_EN), R1.2
Crystal+: 40.0MHz-Crystral.1, C3.2, ESP32-C3FH4.30 (XTAL_P)
Crystal-: 40.0MHz-Crystral.3, C4.2, ESP32-C3FH4.29 (XTAL_N)
GND: 40.0MHz-Crystral.2 (GND), 40.0MHz-Crystral.4 (GND__1), C3.1, C4.1, C5.1, C6.1, C7.1, C8.1, C9.2, C10.1, C11.1, C12.1, ESP32-C3FH4.33 (GND)
LED_DATA: ESP32-C3FH4.9 (GPIO4/MTMS)
unnamed: C11.2, ESP32-C3FH4.18 (VDD_SPI)
unnamed: ESP32-C3FH4.6 (GPIO2), R2.2
unnamed: ESP32-C3FH4.14 (GPIO8), R3.2
UART_RX: ESP32-C3FH4.27 (GPIO20/U0RXD)
UART_TX: ESP32-C3FH4.28 (GPIO21/U0TXD)
USB_DATA+: ESP32-C3FH4.26 (GPIO19/USB_D+)
USB_DATA-: ESP32-C3FH4.25 (GPIO18/USB_D-)
