Normansrule/twinkling-butterfly/hardware/LED Butterfly/Power.kicad_sch

## KiCad design hardware/LED Butterfly/Power.kicad_sch (2026-10-02)

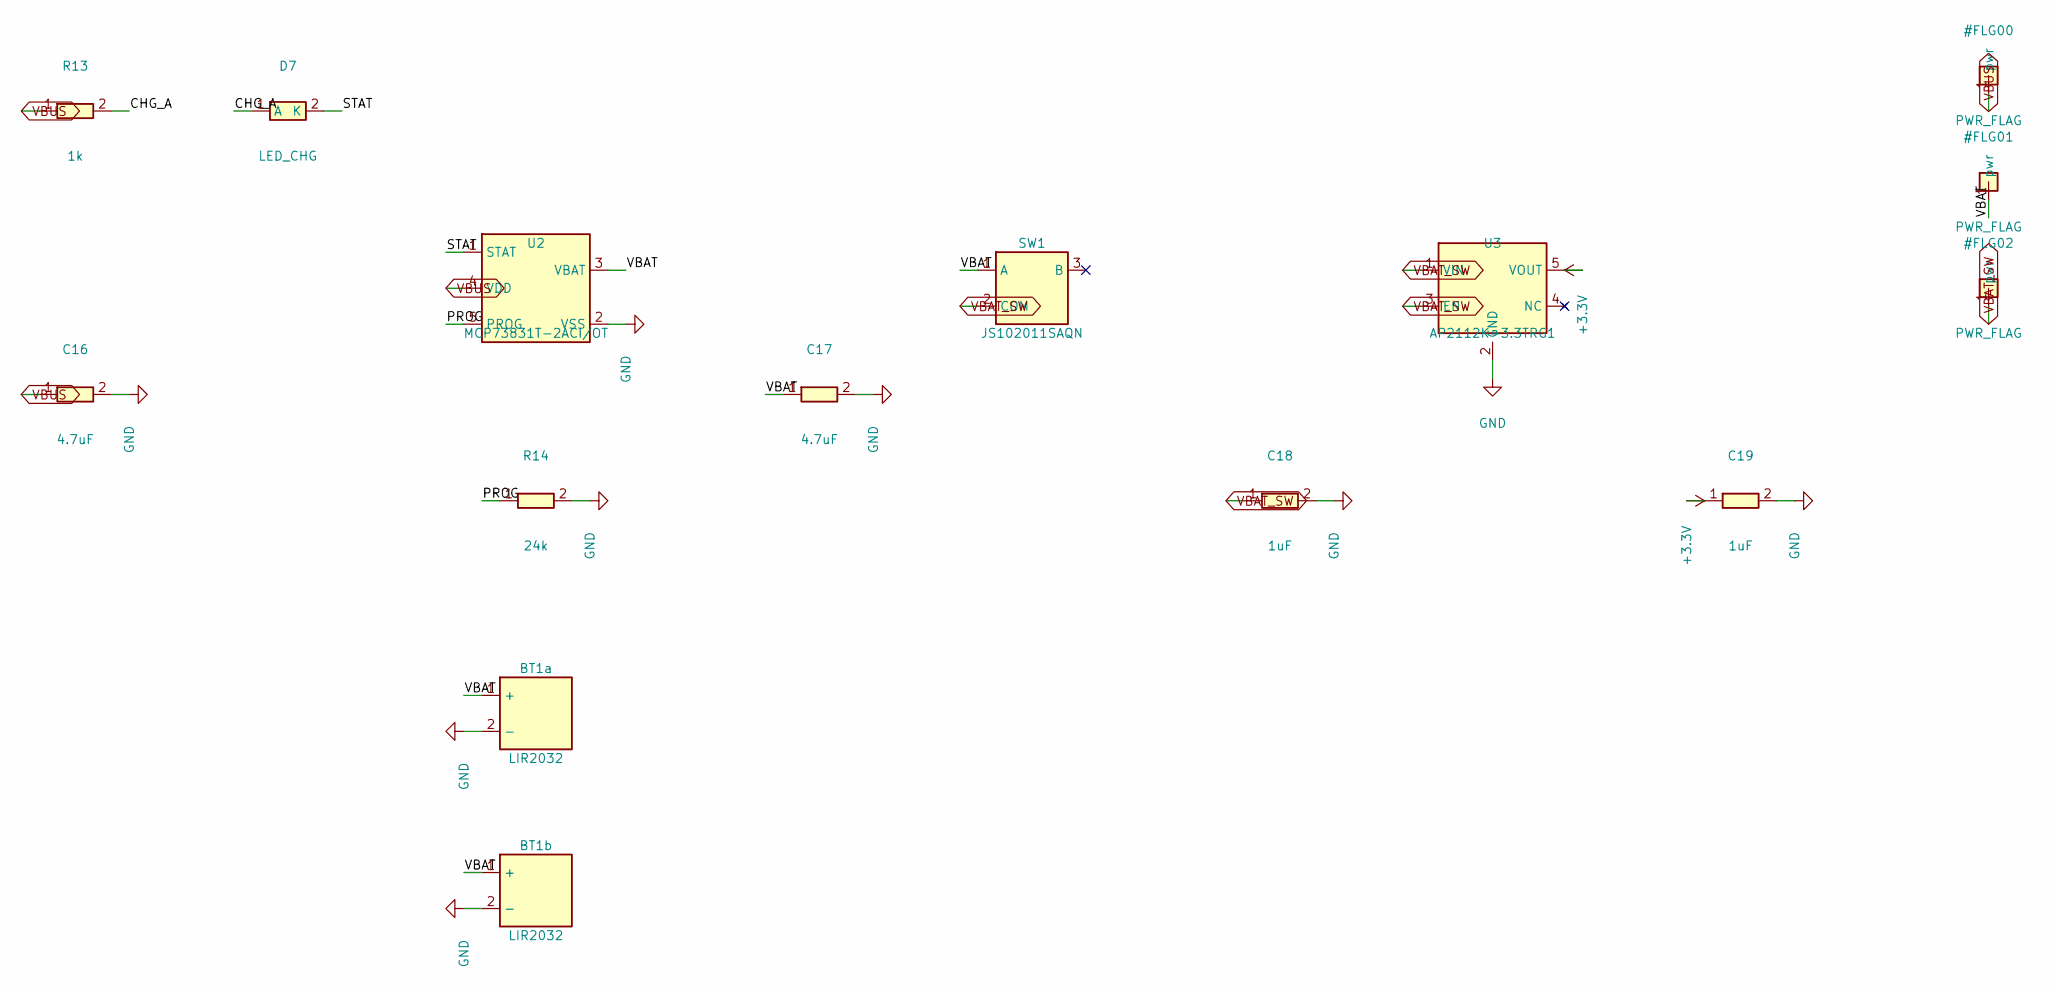
[picture p7: schematic Power.kicad_sch]

Parts:
BT1a, BT1b: LIR2032; BatteryHolder_Keystone_3034_1x20mm
C16, C17: 4.7uF; C_1206_3216Metric
C18, C19: 1uF; C_1206_3216Metric
D7: LED_CHG; LED_1206_3216Metric
R13: 1k; R_1206_3216Metric
R14: 24k; R_1206_3216Metric
SW1: JS102011SAQN; SW_SPDT_CK-JS102011SAQN
U2: MCP73831T-2ACI/OT; SOT-23-5
U3: AP2112K-3.3TRG1; SOT-23-5

Connections:
+3.3V: C19.1, U3.5 (VOUT)
CHG_A: D7.1 (A), R13.2
GND: BT1a.2 (-), BT1b.2 (-), C16.2, C17.2, C18.2, C19.2, R14.2, U2.2 (VSS), U3.2 (GND)
PROG: R14.1, U2.5 (PROG)
STAT: D7.2 (K), U2.1 (STAT)
VBAT: BT1a.1 (+), BT1b.1 (+), C17.1, SW1.1 (A), U2.3 (VBAT)
VBAT_SW: C18.1, SW1.2 (COM), U3.1 (VIN), U3.3 (EN)
VBUS: C16.1, R13.1, U2.4 (VDD)
