Normansrule/twinkling-butterfly/hardware/LED Butterfly/USB_UART.kicad_sch

## KiCad design hardware/LED Butterfly/USB_UART.kicad_sch (2026-10-02)

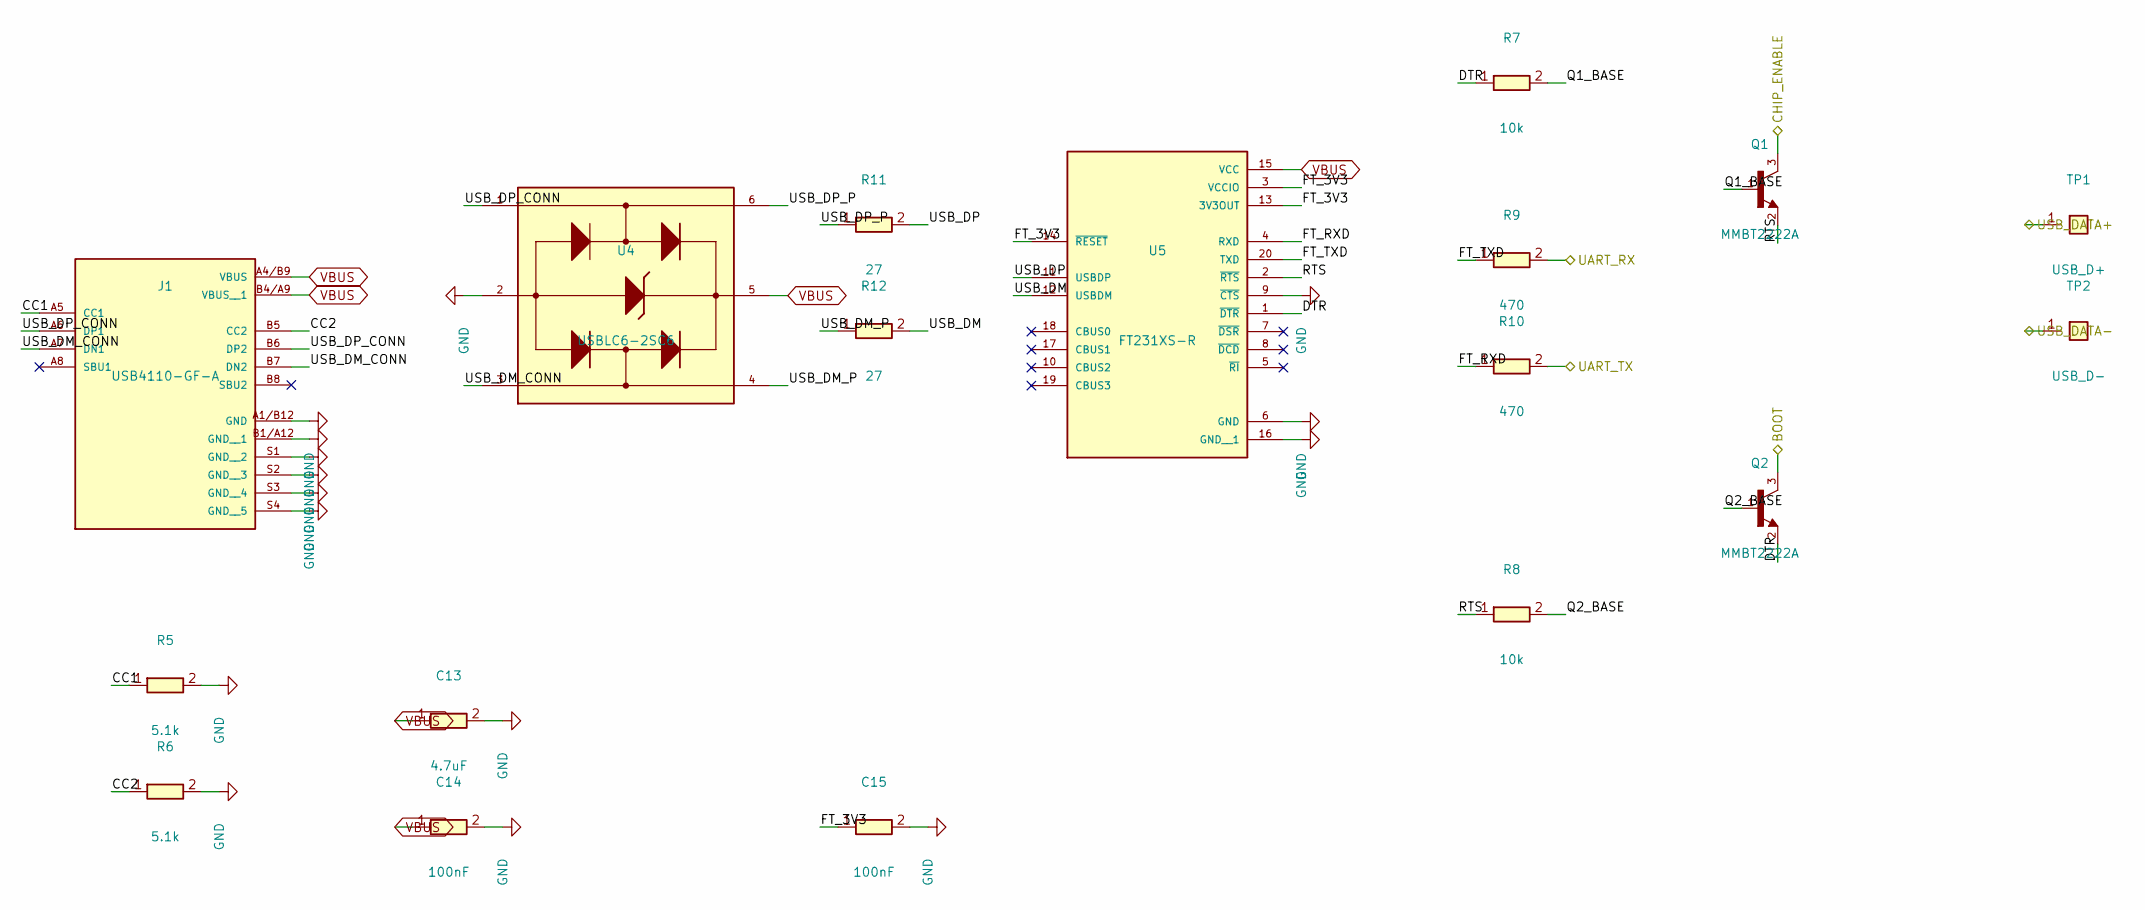
[picture p8: schematic USB_UART.kicad_sch]

Parts:
C13: 4.7uF; C_1206_3216Metric
C14, C15: 100nF; C_1206_3216Metric
J1: USB4110-GF-A
Q1, Q2: MMBT2222A
R5, R6: 5.1k; R_1206_3216Metric
R7, R8: 10k; R_1206_3216Metric
R9, R10: 470; R_1206_3216Metric
R11, R12: 27; R_1206_3216Metric
TP1: USB_D+; TestPoint_Pad_1.5x1.5mm
TP2: USB_D-; TestPoint_Pad_1.5x1.5mm
U4: USBLC6-2SC6
U5: FT231XS-R

Connections:
BOOT: Q2.3
CC1: J1.A5 (CC1), R5.1
CC2: J1.B5 (CC2), R6.1
CHIP_ENABLE: Q1.3
DTR: Q2.2, R7.1, U5.1 (~DTR)
FT_3V3: C15.1, U5.3 (VCCIO), U5.13 (3V3OUT), U5.14 (~RESET)
FT_RXD: R10.1, U5.4 (RXD)
FT_TXD: R9.1, U5.20 (TXD)
GND: C13.2, C14.2, C15.2, J1.A1/B12 (GND), J1.B1/A12 (GND__1), J1.S1 (GND__2), J1.S2 (GND__3), J1.S3 (GND__4), J1.S4 (GND__5), R5.2, R6.2, U4.2, U5.6 (GND), U5.9 (~CTS), U5.16 (GND__1)
Q1_BASE: Q1.1, R7.2
Q2_BASE: Q2.1, R8.2
RTS: Q1.2, R8.1, U5.2 (~RTS)
UART_RX: R9.2
UART_TX: R10.2
USB_DATA+: TP1.1
USB_DATA-: TP2.1
USB_DM: R12.2, U5.12 (USBDM)
USB_DM_CONN: J1.A7 (DN1), J1.B7 (DN2), U4.3
USB_DM_P: R12.1, U4.4
USB_DP: R11.2, U5.11 (USBDP)
USB_DP_CONN: J1.A6 (DP1), J1.B6 (DP2), U4.1
USB_DP_P: R11.1, U4.6
VBUS: C13.1, C14.1, J1.A4/B9 (VBUS), J1.B4/A9 (VBUS__1), U4.5, U5.15 (VCC)
