Normansrule/twinkling-butterfly/(commit log)

2026-10-02 Twinkling Butterfly: all-SMD board, butterfly outline and silkscreen, generated schematic sheets, firmware
    Claude-Session: https://claude.ai/code/session_01TYhYxSU8EhXBMezX2ocDTd
    [LED Butterfly.kicad_pcb, LED Butterfly.kicad_sch, LED.kicad_sch, Main.kicad_sch, Power.kicad_sch, USB_UART.kicad_sch, bom.csv, butterfly_outline.dxf]
2026-10-02 Manufacturing package, pin-by-pin connections, 3D files and a visual README
    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
    [butterfly_board.stl, butterfly_stand.stl]
